Sergel1/Hacklide-Kinetic-Nexus/docs/Kinetic_Nexus_T2_SolidWorks_Handoff.docx

KINETIC NEXUS

# T2 Telescoping Hex Tube SolidWorks Handoff

Progress summary, parametric model logic, mistakes corrected, and restart checklist

Item | Status
Part/configuration | T2 telescoping hex tube
CAD platform | SolidWorks Student Edition
Primary specification | Kinetic-Nexus Build Specification PDF only
Model state at handoff | Main tube, reliefs, chamfers, band fillets, master ribs and circular rib pattern created
Prepared | 16 October 2026

Important source rule Reference pictures are for visual guidance only. All dimensions must come from the Kinetic-Nexus PDF or established global variables. Never scale dimensions from pictures.

# 1. Executive Summary

The T2 tube was rebuilt as a parametric hollow hexagonal tube. The session focused on correcting the relationship between the guide band, lower relieved section, stop band, and upper relieved body. The final modeling logic uses named global variables and configuration-driven values rather than isolated fixed numbers.

- Confirmed cross-section values: full-size outer AF 27.55 mm, bore AF 23.55 mm, relieved outer AF 26.35 mm, full wall 2.00 mm, relieved wall 1.40 mm.
- Confirmed axial logic: guide band 0–6 mm, lower relief 6–27 mm, stop band 27–33 mm, upper relief 33–165 mm.
- Tube-mouth chamfer uses the six inside bore edges; the bottom-end chamfer uses the six outside perimeter edges.
- Guide-band ribs were modeled as two 0.50 mm-wide rectangles, boss-extruded 0.15 mm outward, then circular-patterned around six faces using the longitudinal tube axis.
- The circular-pattern preview showed two ribs per face, six instances, 360° equal spacing, for 12 ribs total.

Current confidence The core dimensional logic is strong. Before manufacturing/export, perform the final rebuild and checklist in Section 9, especially verifying the accepted rib pattern, one solid body, and no warnings.

# 2. Estimated Time Spent

Based on the screenshot timestamps, the focused troubleshooting/modeling session ran from approximately 19:09 to 21:33 on 16 October 2026, or about 2 hours 24 minutes. Allowing for actions between screenshots, a fair practical estimate is:

Estimate | Time
Direct visible session | ~2 h 24 min
Likely active CAD time including unrecorded clicks/rebuilds | ~2.5–3.0 h
Recommended reported time | About 2 h 30 min

This estimate covers the evening session represented by the screenshots, not earlier work on the original tube, design table, or global-variable setup.

# 3. Confirmed T2 Dimensions and Relationships

Parameter | Value | How it is controlled / checked
Full-size outer AF | 27.55 mm | Global variable AF; opposite outer flats
Bore AF | 23.55 mm | AF − 2 × wall
Wall thickness at full-size bands | 2.00 mm | Global variable wall
Relieved outer AF | 26.35 mm | AF − 2 × relief
Relief per outer face | 0.60 mm | Global variable relief
Relieved wall thickness | 1.40 mm | (26.35 − 23.55) / 2
Overall tube length | 165.00 mm | Global variable L
Guide-band length | 6.00 mm | tail_h
Lower-relief length | 21.00 mm | stop_top − stop_h − tail_h
Stop-band bottom position | 27.00 mm | 6 + 21
Stop-band top position | 33.00 mm | stop_top
Stop-band axial length | 6.00 mm | 33 − 27
Upper-relief length | 132.00 mm | L − stop_top
Tube-mouth chamfer | 0.80 mm | Six inside bore edges
Bottom-end chamfer | 0.80 mm | Six outside perimeter edges
Band corner fillets | 0.50 mm radius | Six longitudinal corners on each full-size band
Rib width | 0.50 mm | Two rectangles on one guide-band face
Rib projection | 0.15 mm | Boss-Extrude outward
Rib pattern | 6 instances / 360° | Two ribs per face; 12 total

# 4. Parametric Setup

## Global variables used

Variable | Meaning
AF | Full-size outside flat-to-flat dimension
wall | Tube wall thickness
L | Overall tube length
clr | Clearance
step | Size step between tube configurations
tail_h | Guide-band axial length
stop_h | Stop-band axial length
relief | Material removed from each relieved outer face
stop_top / stop_band_top | Stop-band top position from the designated bottom end; use the exact existing name consistently

## Required equations

- Outer profile = "AF"
- Main extrusion = "L"
- Bore profile/offset = "AF" − 2 × "wall" (or offset = "wall")
- Relief profile AF = "AF" − 2 × "relief"
- Stop-band-top plane = "stop_top"
- Lower-relief start offset = "tail_h"
- Lower-relief depth = "stop_top" − "stop_h" − "tail_h"
- Upper-relief depth = "L" − "stop_top"

SolidWorks behavior Numeric fields may display the evaluated value instead of the variable name. A dimension is only truly linked if Manage Equations contains a row such as D1@Feature = "L", and changing the global variable rebuilds the geometry.

# 5. Recommended Feature Tree Names

T2_Full_AF_Extrusion

T2_Full_AF_Profile

T2_Bore_Cut

T2_Bore_Profile

T2_Lower_Body_Relief

T2_Lower_Relief_Profile

T2_Stop_Band_Top_Plane

T2_Upper_Body_Relief

T2_Upper_Relief_Profile

T2_Bottom_End_Chamfer

T2_Tube_Mouth_Chamfer

T2_Stop_Band_Corner_Fillets

T2_Guide_Band_Corner_Fillets

T2_Guide_Band_Ribs_Master

T2_Guide_Band_Rib_Profile

T2_Tube_Center_Axis

T2_Guide_Band_Rib_Pattern

# 6. Final Modeling Logic

1. Create the full 27.55 mm AF outer hexagon and extrude it to 165 mm.
2. Cut the continuous 23.55 mm AF bore, preserving 2.00 mm walls at full-size regions.
3. Create the lower relief using a 6 mm From Offset and a 21 mm cut depth, removing only the narrow ring between 27.55 mm and 26.35 mm AF.
4. Place the stop-band-top plane 33 mm from the designated bottom/guide-band end.
5. Create the upper relief from the 33 mm plane for 132 mm toward the long end, again cutting only the narrow relief ring.
6. This leaves untouched full-size regions at 0–6 mm and 27–33 mm.
7. Chamfer the six outer edges at the bottom end by 0.80 mm and the six inner bore edges at the tube mouth by 0.80 mm.
8. Apply 0.50 mm corner fillets only to the six longitudinal outer corners of each full-size band.
9. Create two 0.50 mm-wide rib rectangles on one guide-band face, extrude 0.15 mm outward with Merge Result enabled, and pattern the Boss-Extrude feature six times around the longitudinal axis.

# 7. Errors Encountered and Corrections

Problem | Cause | Correction
Global variable displayed as a number and did not drive geometry | Variable existed but feature dimension had no equation link | Added dimension equation in Manage Equations, e.g. D1@Boss-Extrude1 = "L"; confirmed by changing L and rebuilding
Design-table AF error/obsolete warning | Incorrect syntax or stale $VALUE@AF@EQUATIONS control | Used exact global-variable name and design-table equation syntax; kept one control chain
Upper/lower relief created rectangular openings | Wrong contour, Flip Side to Cut, or old faulty Body_Relief_Cut remained active | Used two-hexagon ring profile, selected only narrow ring, Flip Side to Cut off, suppressed obsolete cut
Lower relief initially started at the end face | 21 mm cut started at 0 mm, creating wrong band widths | Changed From condition to Offset = tail_h = 6 mm
Stop-band plane was 33 mm from the wrong end | Plane referenced Front Plane/opposite end | Referenced designated bottom end face and offset 33 mm inward
Upper and lower relief directions appeared swapped | Direction arrows pointed outside or toward wrong side | Upper relief points from 33 mm plane to long end; lower relief points from 6 mm position toward 27 mm
Stop band appeared wrong | 33 mm position was confused with 6 mm band length | Recognized stop band occupies 27–33 mm; 33 mm is a position, not thickness
Measurements gave 0.4 mm, 13.6 mm, or 25.55 mm | Wrong points/edges/faces selected | Verified through equations and opposite parallel faces instead of mixed inner/outer entities
Plane lost reference after cuts | Plane referenced a model face changed by downstream features | Repaired with a stable end-face reference; monitor for future topology changes
Chamfer/fillet errors after geometry changes | Edge IDs changed when relief/plane was repaired | Edited feature, cleared missing references, reselected real edges
Wrong circular pattern axis | Axis ran across tube width | Created longitudinal axis through bore center, perpendicular to end-profile plane
Circular pattern showed no ribs | Patterned sketch instead of Boss-Extrude feature | Created T2_Guide_Band_Ribs_Master and patterned that enabled feature
Ribs risked touching fillets/chamfers | Rectangles coincident with uncertain rounded boundaries | Kept rectangles on the flat guide-band face; use fully defined symmetric placement and avoid sliver geometry

# 8. Current State at End of Session

- One solid body was maintained during the main tube work.
- Cross-sectional dimensions were measured and matched: 27.55 mm, 23.55 mm, and 26.35 mm.
- Stop-band logic was corrected to leave a 6 mm raised ring from 27 mm to 33 mm.
- Mouth and bottom chamfer edge selection was corrected.
- Stop-band and guide-band corner fillets were repaired/created; verify no red icons remain after final rebuild.
- Longitudinal center axis was corrected and visible along the tube length.
- Circular rib pattern preview appeared correct: six equal instances around 360°, two ribs per face.

Exact resume point Open the part, accept/verify T2_Guide_Band_Rib_Pattern if not already accepted, press Ctrl+Q, inspect the full guide band, then save. Do not restart the geometry unless the checklist below fails.

# 9. Restart and Final QA Checklist

☐ Activate the T2 configuration.

☐ Press Ctrl+Q and verify there are no red crosses or yellow warning triangles.

☐ Confirm Solid Bodies(1).

☐ Confirm AF = 27.55 mm, bore AF = 23.55 mm, relieved AF = 26.35 mm.

☐ Confirm overall length = 165 mm.

☐ Check lower relief: From Offset = 6 mm; depth = 21 mm; direction inward.

☐ Check stop-band-top plane: 33 mm from designated bottom end.

☐ Check upper relief: starts at 33 mm plane; depth = 132 mm toward long end.

☐ Confirm visible sequence: raised guide band, recessed lower section, raised 6 mm stop band, long recessed upper section.

☐ Confirm the mouth chamfer uses only six inside edges and the bottom chamfer uses six outside edges.

☐ Confirm both full-size bands have only their six longitudinal outer corners filleted at R0.50 mm.

☐ Confirm master ribs are 0.50 mm wide and 0.15 mm proud, Merge Result enabled.

☐ Confirm circular pattern uses the longitudinal axis, six instances, 360°, equal spacing, Geometry Pattern enabled.

☐ Count 12 ribs total and verify every rib remains on the guide band.

☐ Turn on Section View and check that the bore is continuous with no rectangular holes or internal notches.

☐ Turn Section View off and save with Ctrl+S.

# 10. Short Handoff Explanation

Use this paragraph if the model must be explained to another person:

“This is the T2 telescoping hex tube from the Kinetic Nexus specification. The model is configuration-driven with global variables controlling the full AF, wall, length, relief, guide band, stop band, and stop-band position. T2 is 27.55 mm AF, 23.55 mm bore AF, and 165 mm long. The outside is relieved to 26.35 mm AF except for a 6 mm guide band at the bottom and a 6 mm stop band from 27 to 33 mm. The mouth has a 0.8 mm inside chamfer, the bottom has a 0.8 mm outside chamfer, and both full-size bands have 0.5 mm corner fillets. Two 0.50 mm-wide, 0.15 mm-high ribs were created on one guide-band face and patterned around all six faces. The biggest corrections were the stop-band reference end, cut directions, contour selection, and patterning the Boss-Extrude instead of the sketch.”

# 11. Known Cautions

- The stop-band plane currently references an end face. If future edits replace that face, the plane can lose its reference. Reattach it to the designated bottom face or use a stable datum with the equivalent offset equation.
- Use the exact existing global-variable name: stop_top or stop_band_top. Do not mix both names in different equations.
- Avoid directly controlling both a global variable and its dependent sketch dimension from the design table. Preferred chain: Design Table → Global Variable → Dimension Equation → Feature.
- Pattern the rib Boss-Extrude, never the sketch alone.
- If a chamfer or fillet fails after upstream edits, repair missing edge references rather than recreating the whole part.
- All further dimensions must be verified against the Kinetic-Nexus PDF, not the reference photographs.

Kinetic Nexus T2 SolidWorks Handoff • 16 October 2026
