Sergel1/Hacklide-Kinetic-Nexus/assets/2D Visualization.jpg

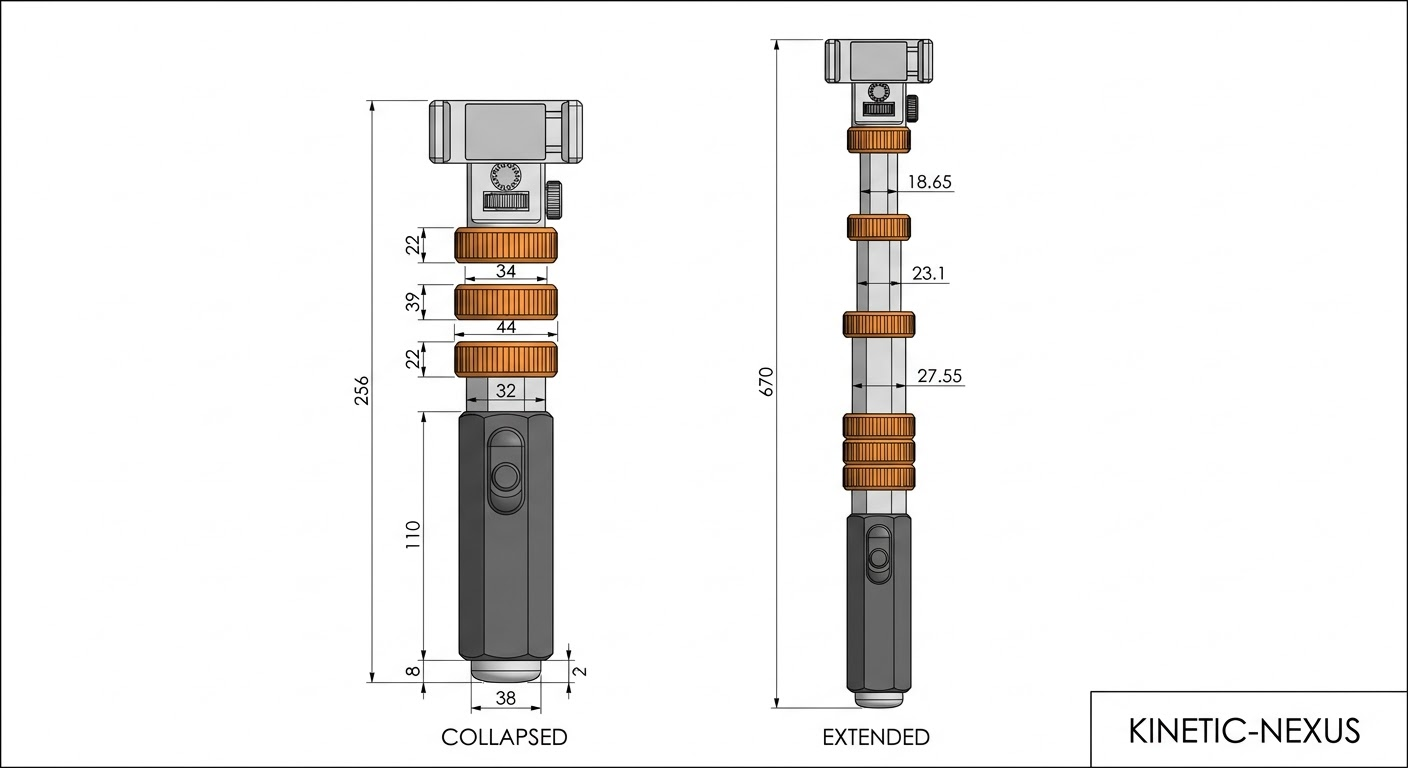
assets/2D Visualization.jpg
