Sergel1/Hacklide-Kinetic-Nexus/assets/3D Visualization.jpg

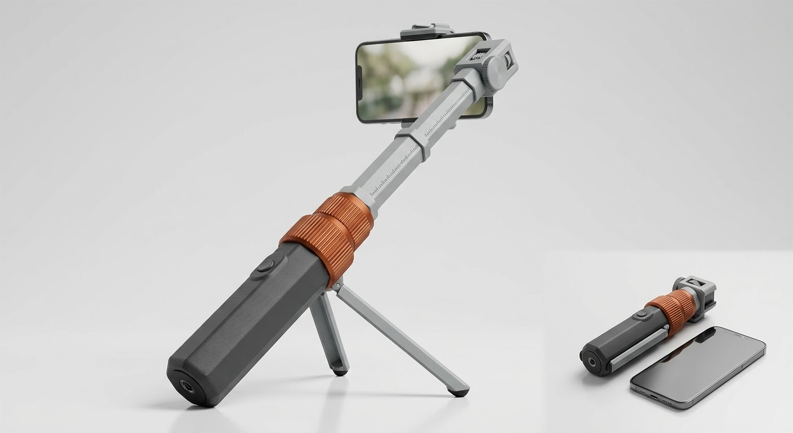
assets/3D Visualization.jpg
