Sergel1/Hacklide-Kinetic-Nexus/BOM.csv

Item | Qty | Supplier | Cost/item | Total Cost | link
3 × 2 mm magnets | 60 | Amazon | $0.12 | $7.20 | https://www.amazon.se/gp/product/B0D31Q6255/ref=ox_sc_act_title_1?smid=A2H7W0QSTPB3IA&psc=1
ruthex RX-1/4"-20 × 12.7 mm brass heat-set inserts, 20-pack | 1 | Amazon | $14.10 | $14.10 | https://www.amazon.se/gp/product/B09MTS6ZZQ/ref=ox_sc_act_title_3?smid=A2LZ0UUKEAXYKL&th=1
361-piece M3 screw, nut, and washer assortment | 1 | Amazon | $8.57 | $8.57 | https://www.amazon.se/gp/product/B0DC4688ZT/ref=ox_sc_act_image_3?smid=A2G9E5HRYQHTHB&psc=1
Estimated total shipping | 1 |  |  | $0.00
