Sergel1/Hacklide-Kinetic-Nexus/Cad/native-solidworks/Kinetic_Nexus_J1_Test_Assembly.SLDASM

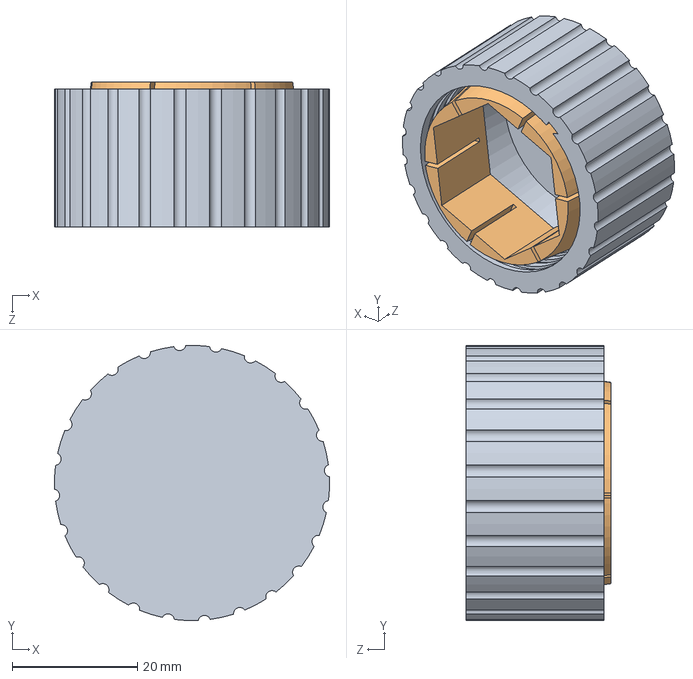
[picture p6: CAD file, 2026-10-19]
Cad/native-solidworks/Kinetic_Nexus_J1_Test_Assembly.SLDASM
44.0 x 44.0 x 23.1 mm
Kinetic_Nexus_J1_Collet
Kinetic_Nexus_J1_Locking_Nut_saved=
