Sergel1/Hacklide-Kinetic-Nexus/Cad/step/Kinetic_Nexus_J1_Test_Assembly_step.STEP

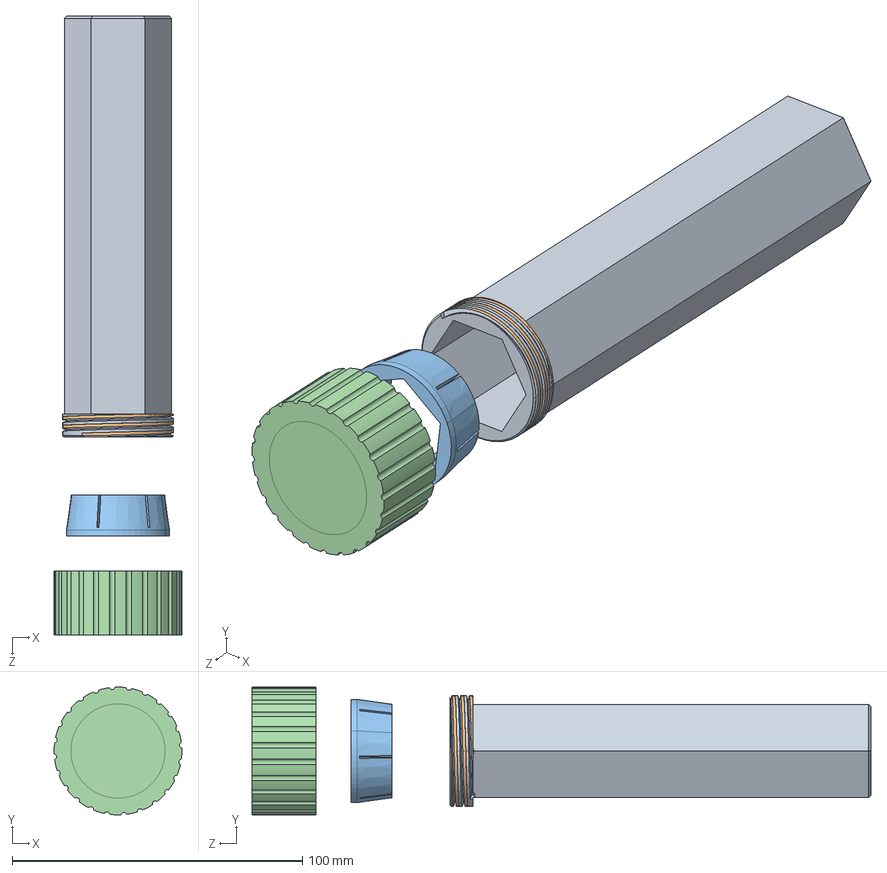
[picture p7: CAD file, 2026-10-19]
Cad/step/Kinetic_Nexus_J1_Test_Assembly_step.STEP
44.0 x 44.0 x 213.1 mm
Kinetic_Nexus_J1_External_Thread_Verified_T1
Kinetic_Nexus_J1_Collet
Kinetic_Nexus_J1_Locking_Nut_saved=
