Sergel1/Hacklide-Kinetic-Nexus/Cad/native-solidworks/Kinetic_Nexus_J1_Collet.SLDPRT

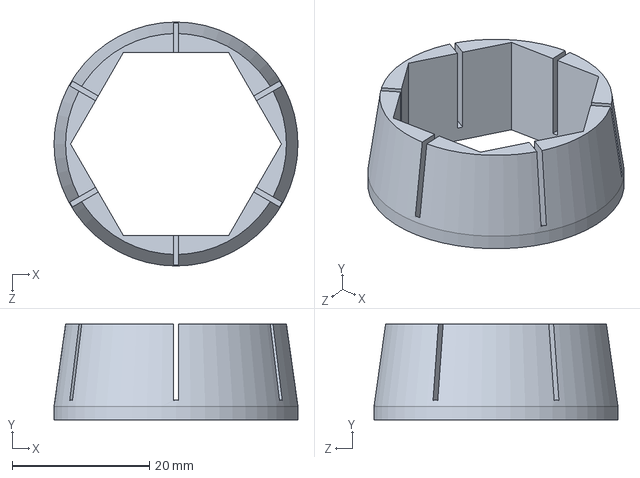
[picture p8: CAD file, 2026-10-19]
Cad/native-solidworks/Kinetic_Nexus_J1_Collet.SLDPRT
35.6 x 14.0 x 35.6 mm
