Sergel1/Hacklide-Kinetic-Nexus/Cad/step/Kinetic_Nexus_J1_External_Thread_Verified_step.STEP

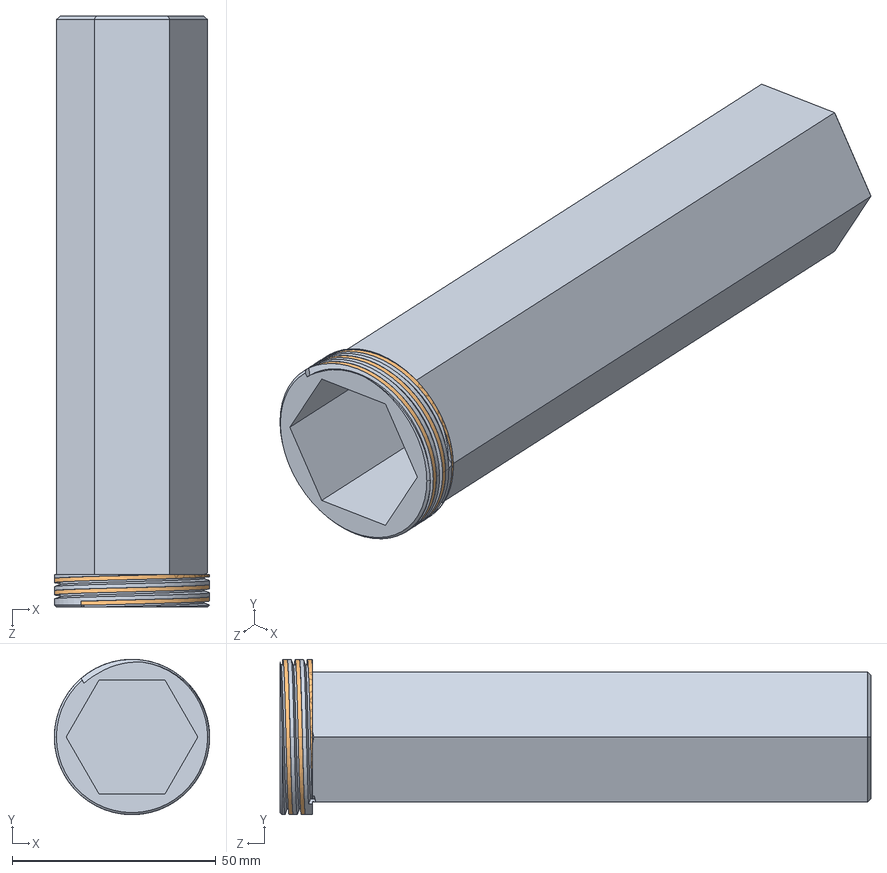
[picture p9: CAD file, 2026-10-19]
Cad/step/Kinetic_Nexus_J1_External_Thread_Verified_step.STEP
38.1 x 38.1 x 145.0 mm
