Sergel1/Hacklide-Kinetic-Nexus/Cad/native-solidworks/Kinetic_Nexus_Tubes_T1-T4+J1_FINAL.SLDPRT

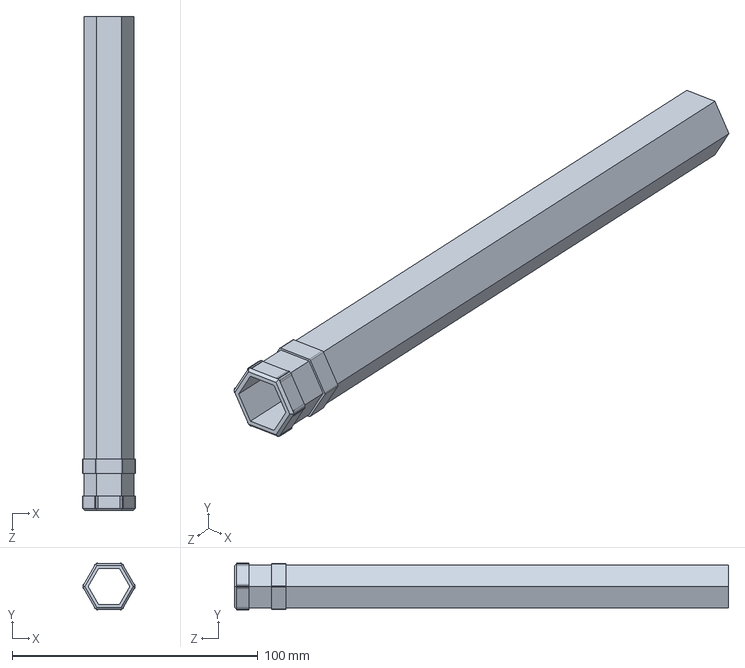
[picture p10: CAD file, 2026-10-19]
Cad/native-solidworks/Kinetic_Nexus_Tubes_T1-T4+J1_FINAL.SLDPRT
21.4 x 19.0 x 201.0 mm
