Sergel1/Hacklide-Kinetic-Nexus/Cad/native-solidworks/Kinetic_Nexus_J1_Locking_Nut_saved=.SLDPRT

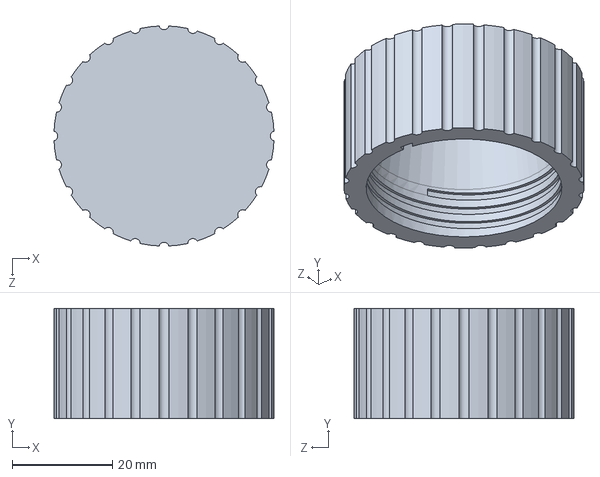
[picture p11: CAD file, 2026-10-19]
Cad/native-solidworks/Kinetic_Nexus_J1_Locking_Nut_saved=.SLDPRT
44.0 x 22.0 x 44.0 mm
