Sergel1/Hacklide-Kinetic-Nexus/Cad/step/Kinetic_Nexus_J1_Locking_Nut_saved_step.STEP

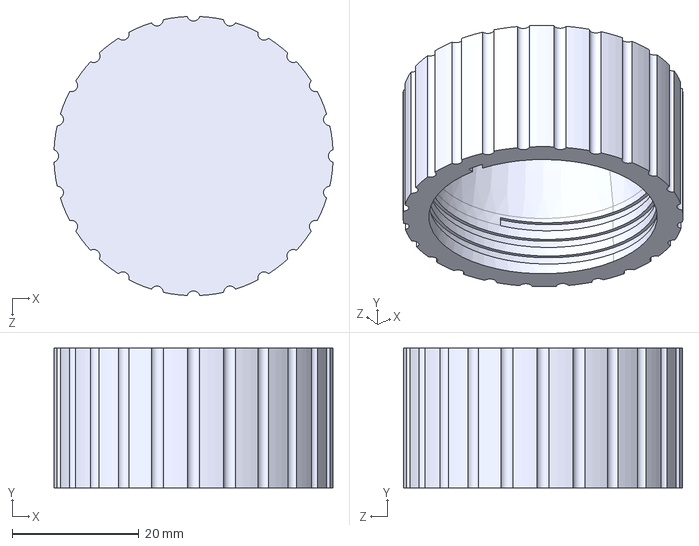
[picture p12: CAD file, 2026-10-19]
Cad/step/Kinetic_Nexus_J1_Locking_Nut_saved_step.STEP
44.0 x 22.0 x 44.0 mm
