Sergel1/Hacklide-Kinetic-Nexus/(list of files, cad)

Other CAD files:
Cad/step/Kinetic_Nexus_J1_Collet_step.STEP
Cad/step/Kinetic_Nexus_Tubes_T1-T4+J1_FINAL_step.STEP
