Sergel1/Hacklide-Kinetic-Nexus/JOURNAL.md

# Kinetic-Nexus – devlog

<!-- Generated by Half Life from project cmv4tigf50fud01n0n5q3u8dp. Edits here are overwritten on the next sync. -->
<!-- Generated: 2026-10-19T02:27:17.342Z -->

> [!NOTE]
> This devlog is mirrored from [Half Life](https://halflife.hackclub.com) – [open the project](https://halflife.hackclub.com/projects/cmv4tigf50fud01n0n5q3u8dp). Editing it here will not change the platform's copy, and the next sync overwrites this file.

> A selfie stick with cool kinetic movements and gears that add to the wow factor, modular build

| Week | Tier | Hours logged | Entries |
| --- | --- | --- | --- |
| Week 2 | Tier 1 | 26.64h | 4 |

## Contents

1. [2026-10-16 – Work session](#2026-10-16-work-session)
2. [2026-10-16 – Work session](#2026-10-16-work-session)
3. [2026-10-17 – Work session](#2026-10-17-work-session)
4. [2026-10-18 – Work session](#2026-10-18-work-session)

## Design

### 2026-10-16 – Work session

**1.42h**

[Timelapse](https://lookout.hackclub.com/api/media/df23a819-2d2a-4e1d-8de3-a5ba13f940d2/video.mp4)

### 2026-10-16 – Work session

**7h**

[Timelapse](https://lookout.hackclub.com/api/media/d2824d02-3da0-4613-b300-471e8341077e/video.mp4)

### 2026-10-17 – Work session

**7.92h**

[Timelapse](https://lookout.hackclub.com/api/media/1f83bdd3-dacf-4e65-b930-90880041b751/video.mp4)

### 2026-10-18 – Work session

**10.3h**

[Timelapse](https://lookout.hackclub.com/api/media/807d70ef-16ed-4538-ad9e-731a4c7d7bd1/video.mp4)
