Sergel1/Hacklide-Kinetic-Nexus/(commit log)

2026-10-17 Sync Kinetic-Nexus from Half Life
    [BOM.csv]
2026-10-19 Create CAD SOURCES
2026-10-19 Add the tube cad source file
    [Kinetic_Nexus_Tubes_T1-T4+J1_FINAL.SLDPRT]
2026-10-19 add asembly files for collet+nut+t1
    [Kinetic_Nexus_J1_Test_Assembly.SLDASM]
2026-10-19 Tubes t1-t4
2026-10-19 Add native-solidwork file to Cad directory
2026-10-19 Add tube 1-4
    [Kinetic_Nexus_Tubes_T1-T4+J1_FINAL.SLDPRT]
2026-10-19 add nut
    [Kinetic_Nexus_J1_Locking_Nut_saved=.SLDPRT]
2026-10-19 Rename Cad/Kinetic_Nexus_Tubes_T1-T4+J1_FINAL.SLDPRT to Cad/native-solidworks /Kinetic_Nexus_Tubes_T1-T4+J1_FINAL.SLDPRT
    [Kinetic_Nexus_Tubes_T1-T4+J1_FINAL.SLDPRT]
2026-10-19 Update BOM.csv description in README
    Clarified the purpose of BOM.csv in the README.
